llange/openinverter-hw-mainboard-mini/documentation/mainboard-mini schematic.pdf

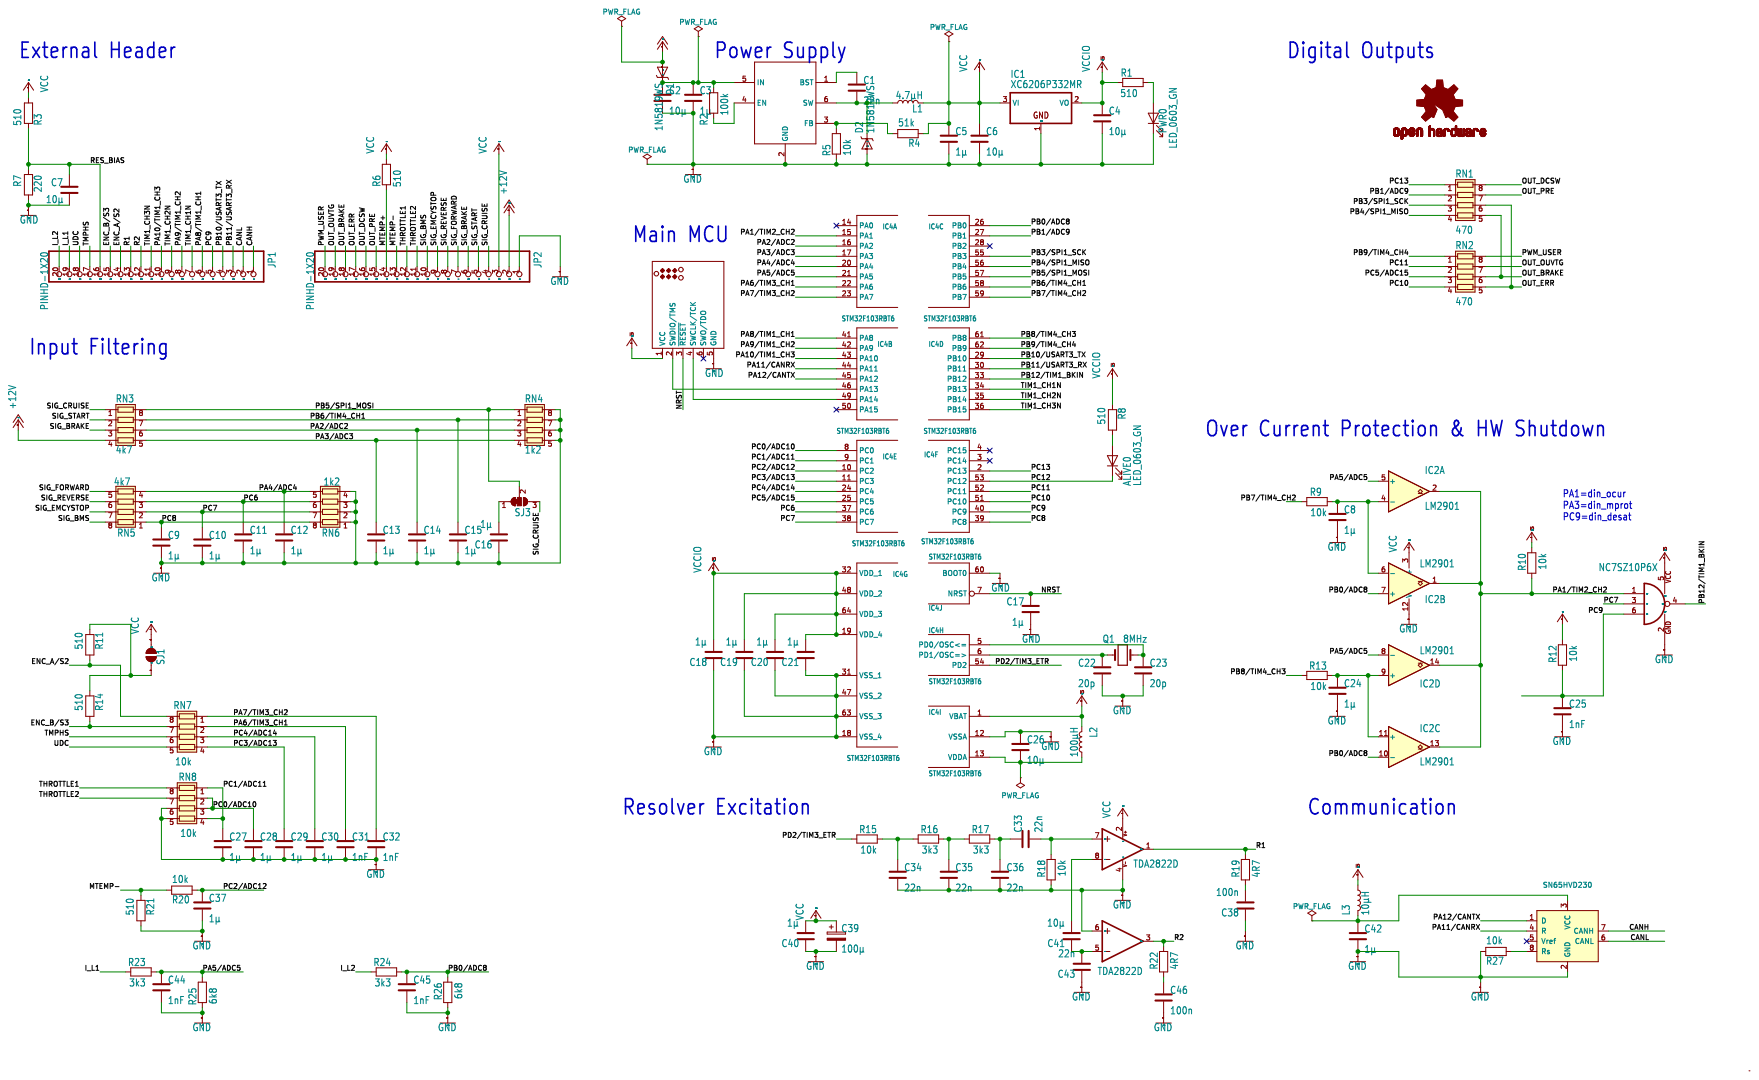
[picture p3: page 1]
