llange/openinverter-hw-mainboard-mini/(commit log)

2022-07-22 Converted board looking good
    [mainboard-mini.kicad_pcb, mainboard-mini.kicad_sch]
2022-07-22 Adding produced files (documentation / production)
    [bom.csv, designators.csv, positions.csv]
