llange/openinverter-hw-mainboard-mini/(notices)

Notices in the files:
mainboard-mini.kicad_pcb:
(C) 2020 Johannes Huebner
parts and their libraries:
©2009 ROFA.cz - modified and updated by Robert Darlington ‹rdarlington@gmail.com›
